Rodrig087/SistemaRegistroContinuo/Firmware/Datos pruebas/Datos pruebas.txt

Tramas de tiempo: 

 tramaTiempoSistema[0] = dia;
 tramaTiempoSistema[1] = mes;
 tramaTiempoSistema[2] = anio;
 tramaTiempoSistema[3] = hora;
 tramaTiempoSistema[4] = minuto;
 tramaTiempoSistema[5] = segundo;

tiempo[0] = 1;
tiempo[1] = 2;
tiempo[2] = 3;
tiempo[3] = 4;
tiempo[4] = 5;
tiempo[5] = 6;

horaSistema = 36672; //10:11:12
fechaSistema = 201216; //20/12/16

TEST = ~TEST;

Paths:
RC: C:\Users\milto\Milton\RSA\Git\Registro Continuo\SistemaRegistroContinuo\Firmware\Acelerografo
SE: C:\Users\milto\Milton\RSA\Git\Salud Estructural\SaludEstructuralCS\Firmware\Master
