Rodrig087/SistemaRegistroContinuo/Documentacion/Esquema/Captura.JPG

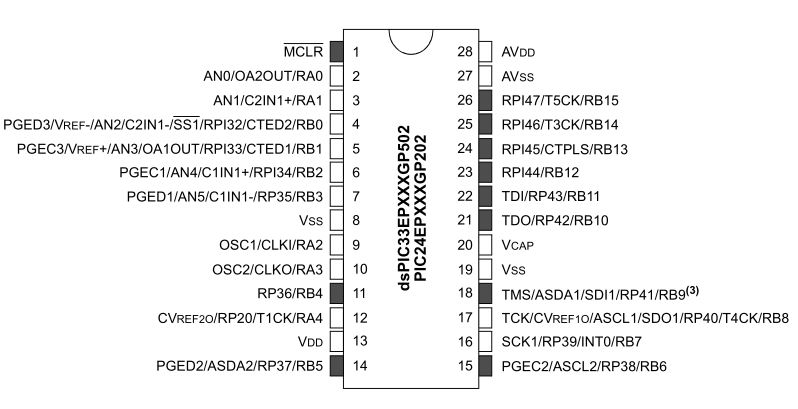
Documentacion/Esquema/Captura.JPG
