Rodrig087/SistemaRegistroContinuo/Documentacion/Esquema/BOM Acelerografo.xlsx

Item | Cantidad | Unidades en Chanlud | Unidades en Labrado | Unidades en Ocaña | Total
Raspberry Pi 3 B+ | 1 | 2 | 1 | 1 | 4
MicroSD 16GB Clase10 | 1 | 2 | 1 | 1 | 4
dsPIC 33EP256MC202 (o 502) | 1 | 2 | 1 | 1 | 4
ADXL355 | 1 | 2 | 1 | 1 | 4
DS3234 | 1 | 0 | 1 | 1 | 2
Modulo GPS Breakout 66 channel w/10 Hz | 1 | 0 | 1 | 1 | 2
Antena GPS | 1 | 0 | 1 | 1 | 2
Fuente 12V2A | 1 | 2 | 1 | 1 | 4
Convertidor DC-DC 5v | 1 | 0 | 1 | 1 | 2
ams1117 3.3v (o similar) | 1 | 0 | 1 | 1 | 2
Peineta hembra | 2 | 0 | 1 | 1 | 4
Peineta macho | 1 | 0 | 1 | 1 | 2
Zocalo 28 pines | 1 | 0 | 1 | 1 | 2
Jumper | 3 | 0 | 1 | 1 | 6
Pila de litio 3V CR1220 | 2 | 2 | 1 | 1 | 8
Holder CR1220 | 1 | 2 | 1 | 1 | 4
Molex 2 pines | 2 | 0 | 1 | 1 | 4
Pulsante | 1 | 0 | 1 | 1 | 2
Capacitor ceramico 1uF | 1 | 0 | 1 | 1 | 2
Capacitor ceramico 100nF | 9 | 0 | 1 | 1 | 18
Capacitor ceramico 10nF | 2 | 0 | 1 | 1 | 4
Capacitor electrolitico 220uF 25V | 1 | 0 | 1 | 1 | 2
Capacitor electrolitico 470uF 25V | 1 | 0 | 1 | 1 | 2
Diodo 1n914 | 1 | 0 | 1 | 1 | 2
Diodo 1n407 | 1 | 0 | 1 | 1 | 2
Resistencia 1K | 3 | 0 | 1 | 1 | 6
Resistencia 4,7K | 1 | 0 | 1 | 1 | 2
Resistencia 3,3K | 1 | 0 | 1 | 1 | 2
Resistencia 10K | 2 | 0 | 1 | 1 | 4
Resistencia 100K | 1 | 0 | 1 | 1 | 2
Led 3mm verde | 2 | 0 | 1 | 1 | 4
Conector RJ45 macho | 1 | 2 | 1 | 1 | 4
Conector AC | 1 | 2 | 1 | 1 | 4
Cable de poder | 1 | 2 | 1 | 1 | 4
Carcasa impresa en 3D | 1 | 2 | 0 | 0 | 2
Carcasa metalica | 1 | 0 | 1 | 1 | 2
Acrilico para montaje | 1 | 0 | 1 | 1 | 2
Bateria 12V | 1 | 3 | 2 | 1 | 6
