Rodrig087/SistemaRegistroContinuo/Software/W10/Convertidor de formato/configuracion_mseed.csv

ESTACION(21) | NOMBRE(0) | CODIGO(1) | SENSOR(2) | CANALES(3) | HAB_CANAL(4) | COMPONENTE(5) | HAB_GRAFICO(6) | HAB_PLT(7) | GAN_PLT(8) | GANANCIA(9) | DIEZ_PLT(10) | FACTOR_MUL(11) | CALIDAD(16) | UBICACION(17) | CANAL(18) | RED(19) | MUESTREO(20) | LONGITUD(12) | LATITUD(13) | ALTITUD(14) | RUIDO(15) | FILTRO(22) | RES1(23) | RES2(24)
1 | TESTX | TSTX | ACELEROGRAFICO | 3 | 1 | 3 | 1 | 1 | 200 | 1 | 5 | 19 | D | 0 | TRV | UC | 250 | -790.283 | -26.753 | 3423 | 0
