Rodrig087/SistemaRegistroContinuo/Software/W10/Convertidor de formato/Instrucciones.docx

Pasos para usar:

1. Los archivos binarios van en la carpeta EventosBin.

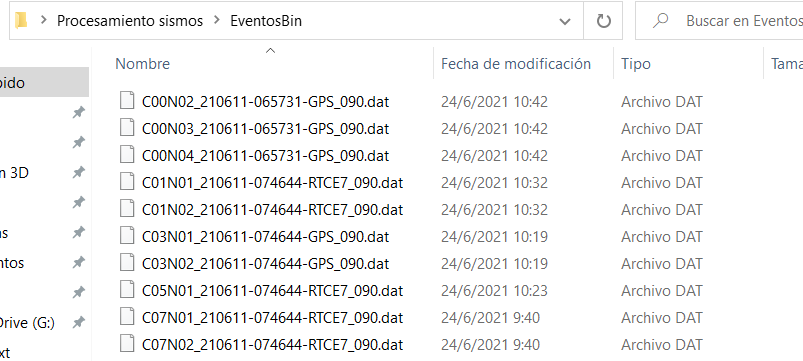
[picture p2: figure]

2. Se ejecuta el programa GraficarExtraerEvento.py.
3. Se coloca el nombre del archivo a convertir sin la extensión .bin.

Ejemplo: C00N02_210611-065731-GPS_090

Al dar enter el programa empieza el calculo y muestra la gráfica.

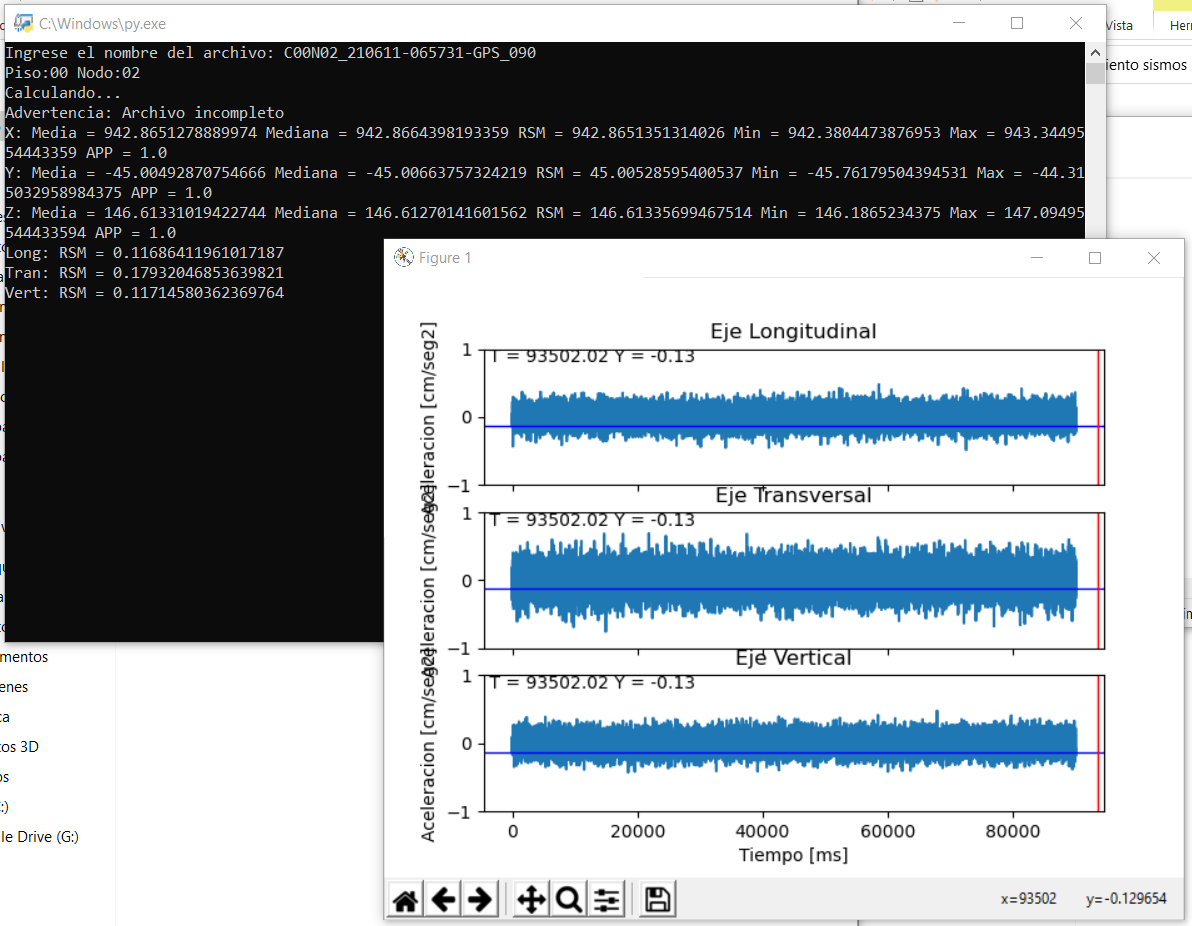
[picture p3: figure]

4. Al cerrar el grafico el programa pregunta si se desea extraer el evento.

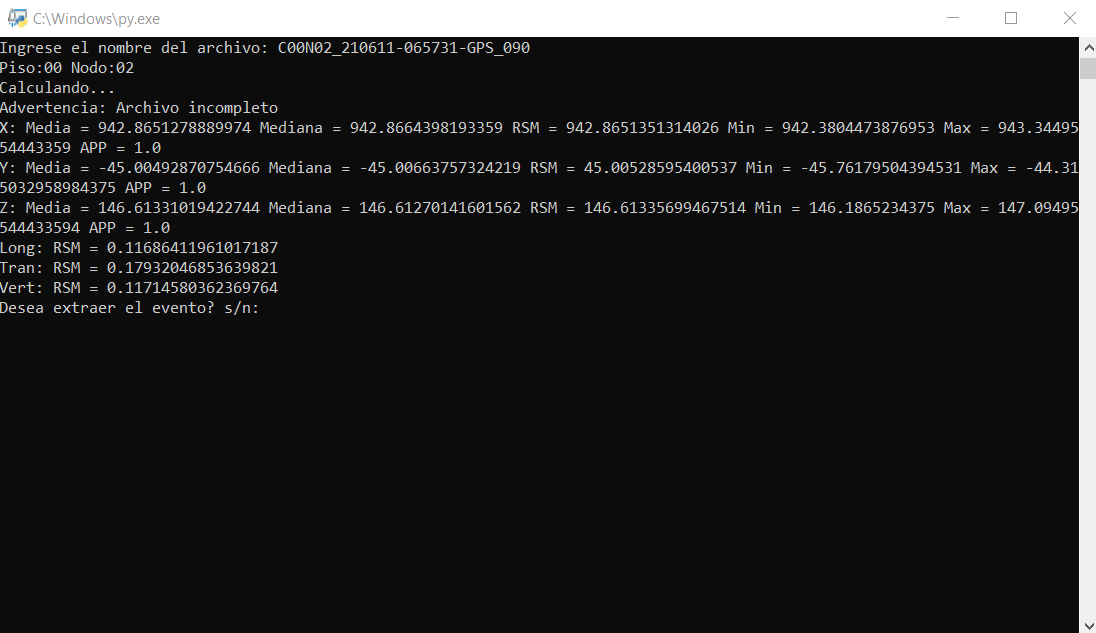
[picture p4: figure]

5. Si se selecciona la opción “s”, el programa extraerá el evento en formato texto en la carpeta EventosTxt y se cerrará de forma automática.

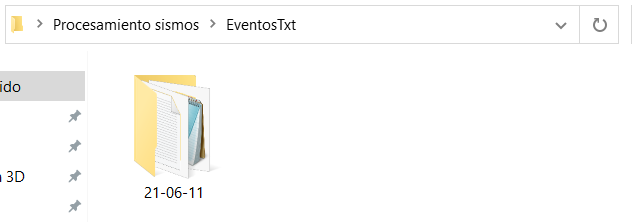
[picture p5: figure]
