Rodrig087/SistemaRegistroContinuo/Documentacion/Esquema/Esquema 3.pdf

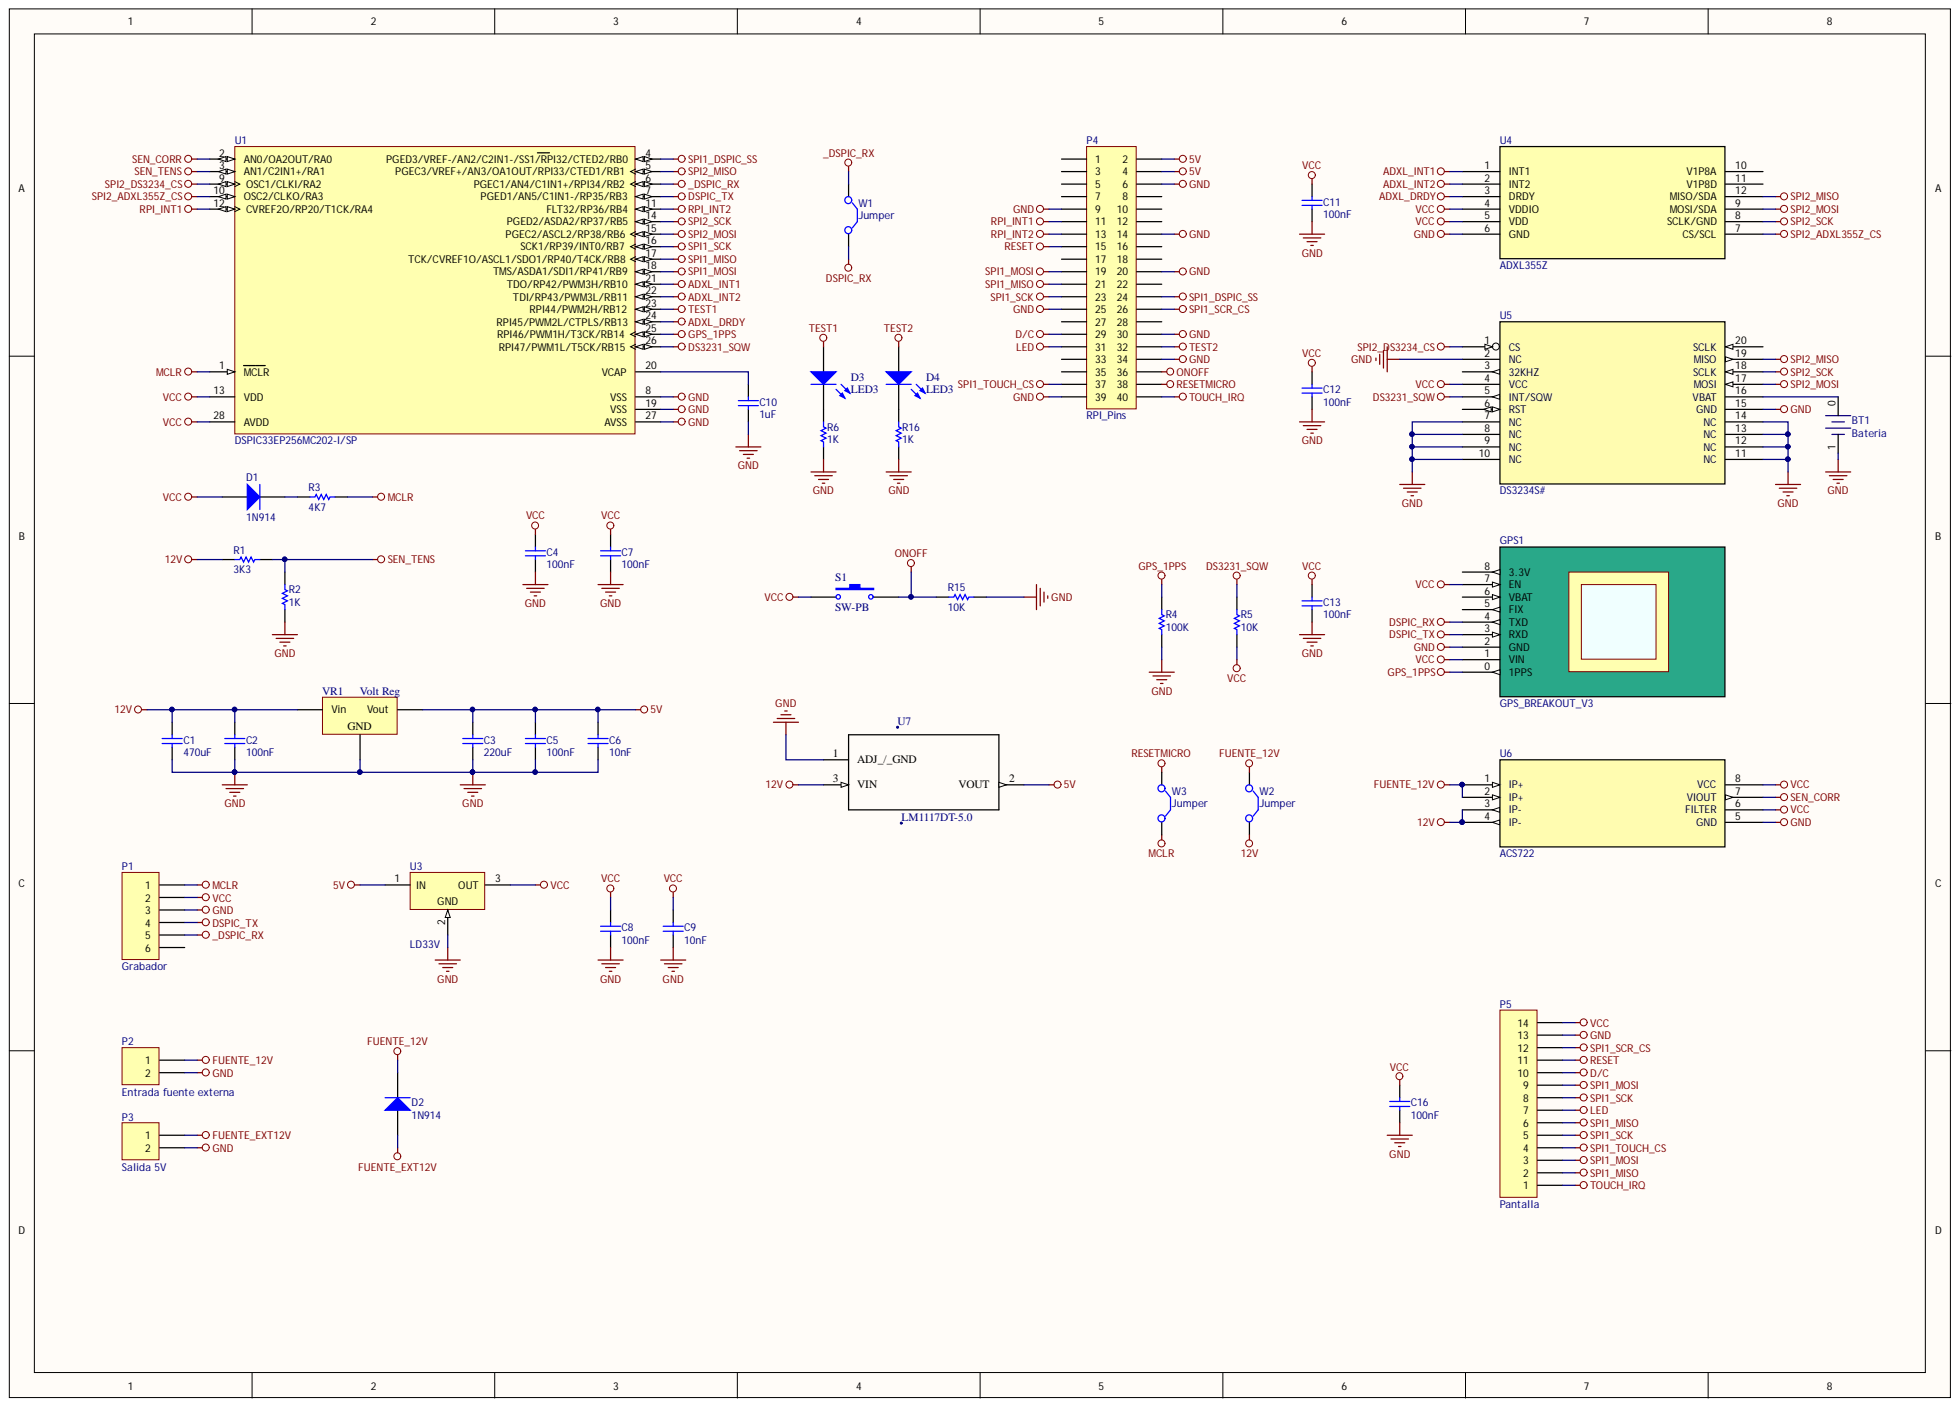
[picture p6: page 1]
