Rodrig087/SistemaRegistroContinuo/Documentacion/Esquema/Esquema2.pdf

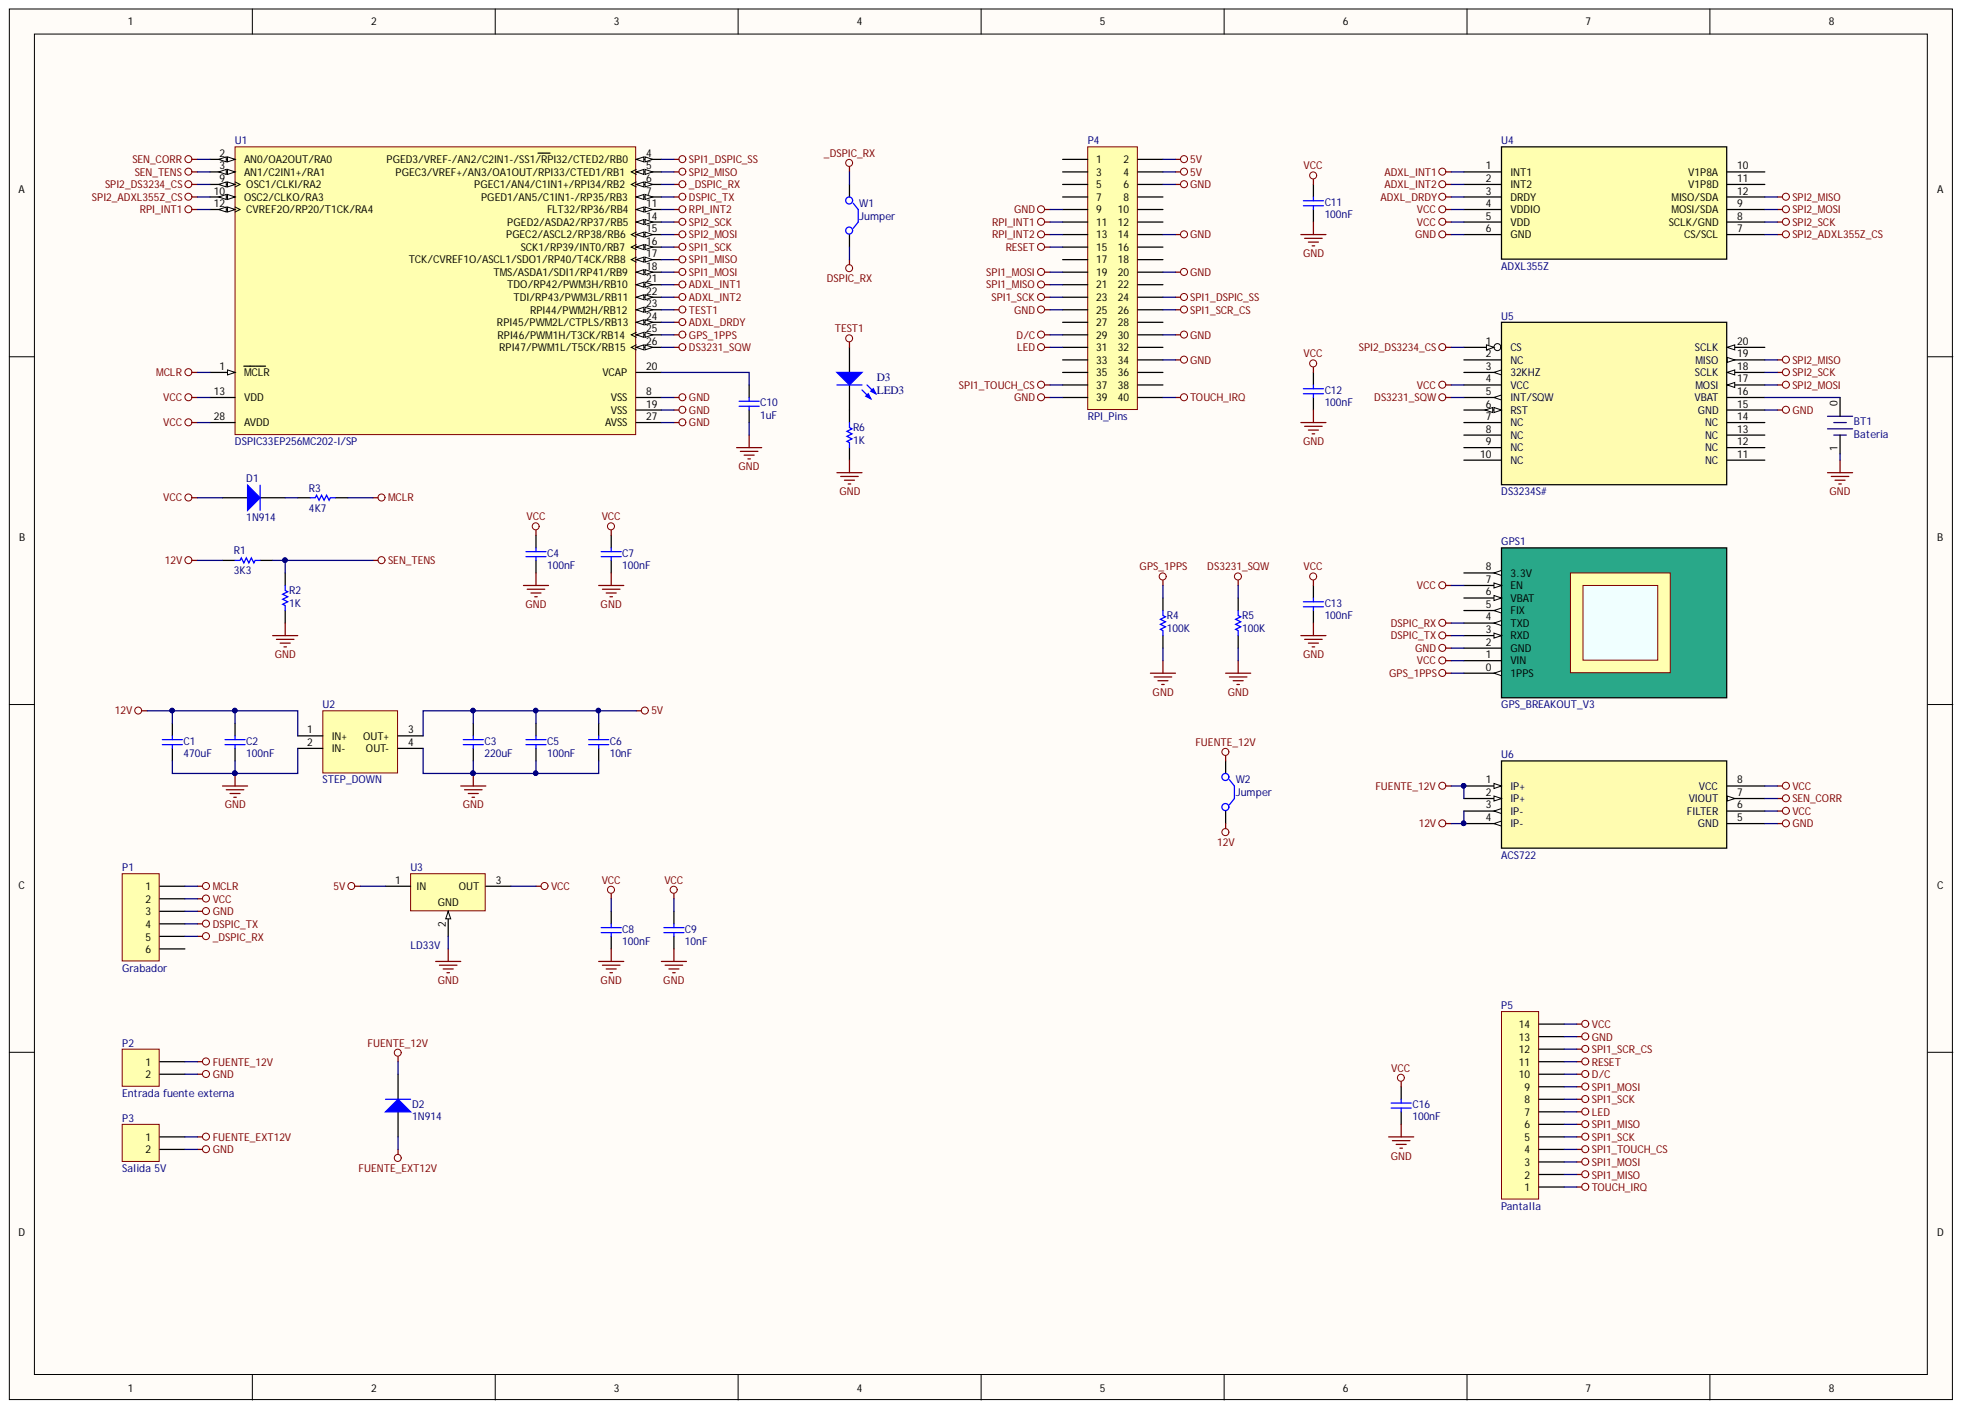
[picture p7: page 1]
