Rodrig087/SistemaRegistroContinuo/Documentacion/Esquema/EsquemaAntiguo.pdf

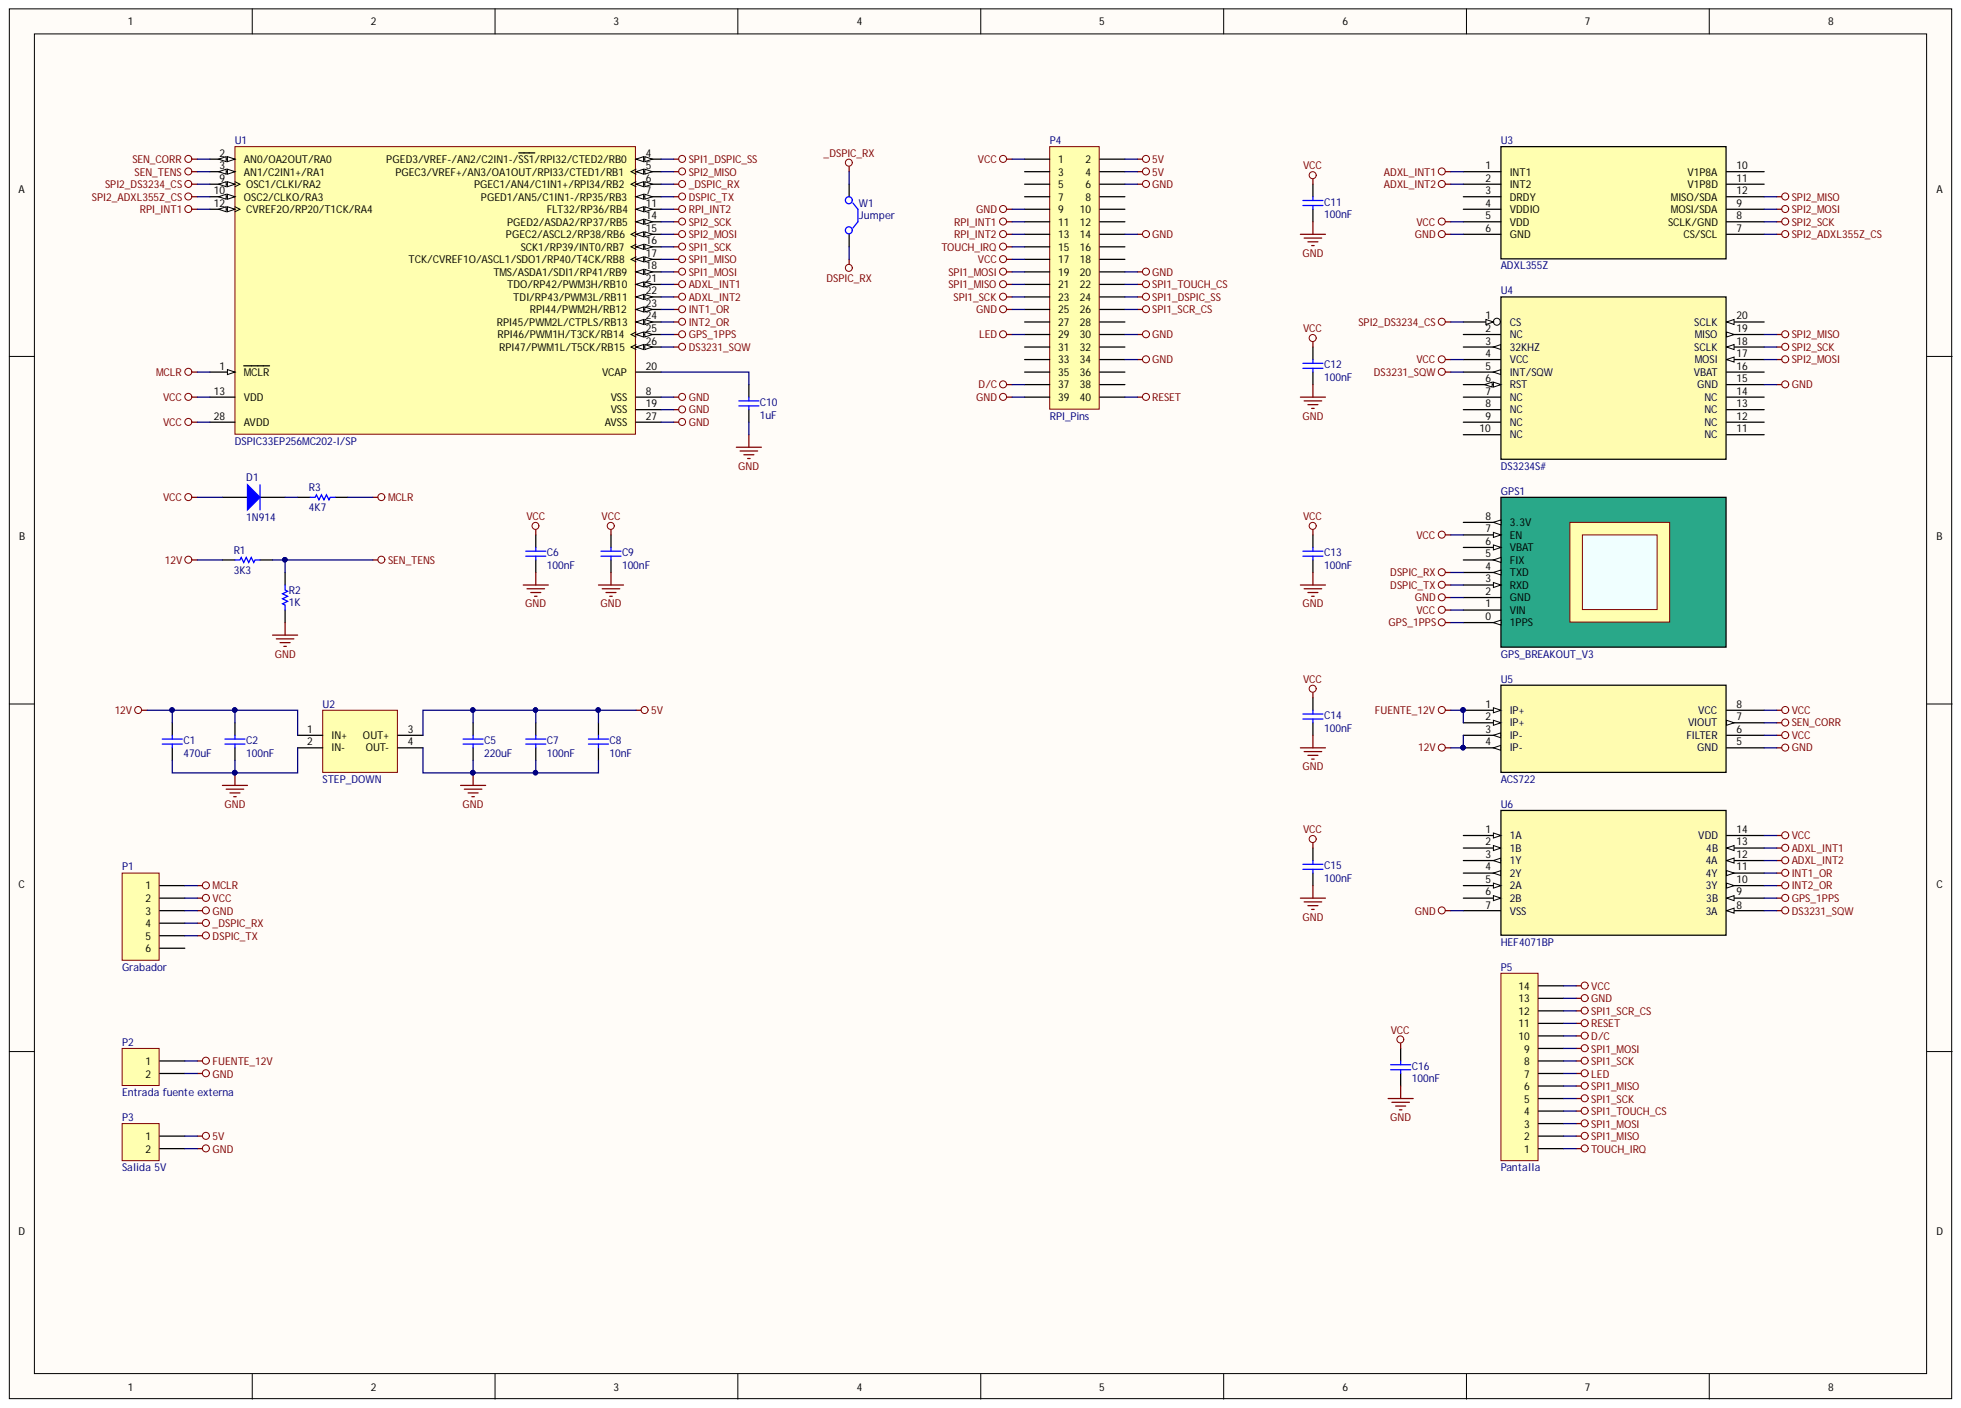
[picture p8: page 1]
