Rodrig087/SistemaRegistroContinuo/(list of files, drawings)

Other design files:
Firmware/Concentrador Principal/Simulacion/SimulacionCP.pdsprj
Firmware/Esclavo/Simulacion/Simulacion.pdsprj
Firmware/Simulacion/Simulacion.pdsprj
Firmware/SimulacionPrincipal/Completa/Simulacion.pdsprj
Firmware/Vertedero/DSP/Simulacion/ADC_DAC.pdsprj
Pruebas/SPI_ConcentradorPrincipal/Simulacion/SimulacionCP.pdsprj
Pruebas/SPI_MaestroEsclavo/Pruebas.pdsprj
RedDatos/Simulacion/Splitter.pdsprj
RedDatos/Splitter/Simulacion/Splitter.pdsprj
