Rodrig087/SistemaRegistroContinuo/Software/RPi/Python/ResetOffButton.py

#!/usr/bin/python
# shutdown/reboot(/power on) Raspberry Pi with pushbutton

import RPi.GPIO as GPIO
from subprocess import call
from datetime import datetime
import time

# pushbutton connected to this GPIO pin, using pin 36 gpio16 also has the benefit of
# waking / powering up Raspberry Pi when button is pressed
shutdownPin = 36

# if button pressed for at least this long then shut down. if less then reboot.
shutdownMinSeconds = 3
led = 40

# button debounce time in seconds
debounceSeconds = 1

GPIO.setmode(GPIO.BOARD)
GPIO.setup(shutdownPin, GPIO.IN, pull_up_down=GPIO.PUD_UP)
GPIO.setup(led, GPIO.OUT)

buttonPressedTime = None

# Enciende el led
GPIO.output(led, GPIO.HIGH)


def buttonStateChanged(pin):
    global buttonPressedTime

    if not (GPIO.input(pin)):
        # button is down
        if buttonPressedTime is None:
            buttonPressedTime = datetime.now()
    else:
        # button is up
        if buttonPressedTime is not None:
            elapsed = (datetime.now() - buttonPressedTime).total_seconds()
            buttonPressedTime = None
            if elapsed >= shutdownMinSeconds:
                # button pressed for more than specified time, shutdown
                call(['shutdown', '-h', 'now'], shell=False)
            elif elapsed >= debounceSeconds:
                # button pressed for a shorter time, reboot
                #call(['shutdown', '-r', 'now'], shell=False)
                call(['reboot'], shell=False)


# subscribe to button presses
GPIO.add_event_detect(shutdownPin, GPIO.BOTH, callback=buttonStateChanged)

while True:
    # sleep to reduce unnecessary CPU usage
    time.sleep(5)
