Rodrig087/SistemaRegistroContinuo/(commit log)

2018-08-01 Se agredo el software de los dispositivos hub-splitter desarrollados en el trabajo de titulacion
    [Splitter.cfg]
2018-08-01 Se agrego un archivo de simulacion en Proteus
    [Splitter.cfg, Splitter.pdsprj]
2018-08-02 Se agregaron los programas de los dispositivos Master y Esclavo del proyecto de titulacion. Ademas se agrego un archivo de simulacion que contiene los 3 dispositivos
    [Esclavo.cfg, Master.cfg, Splitter.pdsprj]
2018-08-03 Se implemento un algoritmo de calculo de CRC16 y se comprobo su correcto funcionamiento en arrays de 4 y 6 elementos
    [Splitter.pdsprj]
2018-08-06 Se establecio la estructura de la trama de datos de peticion y respuesta en un modelo inspirado en el protocolo Modbus ASCII. Esta trama esta conformada por 4 elementos: Header, PDU, CRC y End. El He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
    [Splitter.pdsprj]
2018-08-07 Se modifico el programa del Master para enviar una trama de peticion cada vez que se pulsa un boton. No esta calculando bien el CRC enviado en la trama de peticion. Tambien se implemento un algoritmo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
    [Splitter.pdsprj]
2018-08-13 Se implemento el programa en el dispositivo esclavo, el cual cumple los siguientes pasos: 1. Recibe la trama de peticion y la almacena si cumple las condiciones de delimitacion de trama. 2. Verifica 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
    [Splitter.pdsprj]
2018-08-13 Se implemento un ejemplo completo, donde el maestro realiza una peticion al esclavo cada vez que se presiona un pulsante, y cuando recibe una respuesta satisfactoria enciende un led. Se modificaron l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
    [Splitter.pdsprj]
2018-08-15 Se implemento el TimeOut mediante una interrupcion del TMR1 que inicia su conteo cada vez que inicia una trama. Se comprobo su funcionamiento estableciendo tiempos de interrupcion menores y mayores c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
    [Splitter.pdsprj]
2018-08-16 Se modifico el programa para incluir una funcion que se encarga de armar y enviar las tramas sobre bus RS485. En el maestro esta funcion necesita el numero de bytes de pyload y la funcion requerida, 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
    [Splitter.pdsprj]
2018-10-17 Se cambio el nombre de la carpeta que contiene el proyecto a Firmaware. Ademas de borro las carpetas de los programas que contenian los programas del Esclavo, el Master y sus simulaciones.
    [Master.cfg, Splitter.cfg, Splitter.pdsprj]
2018-10-31 Se esta trabajando en el protocolo de comunicacion de los dispositivos MasterComunicacion y HubSplitter
    [MasterComunicacion.cfg, Simulacion.pdsprj, Splitter.cfg]
2018-11-05 Se esta implementando una simulacion para comprobar el intercambio de tramas de datos entre el Maestro y el Esclavo sin el Splitter
    [EsclavoComunicacion.cfg, Simulacion.pdsprj]
2018-11-08 Se corrigio el problema de la funcion VerficarCRC en el Esclavo cambiando la longitud del vector PDU, al parecer da errores cuando se le fija una longitud mayor a 30 elementos. Tambien se comprobo qu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
    [EsclavoComunicacion.cfg, MasterComunicacion.cfg, Simulacion.pdsprj]
2018-11-28 Se agrego una carpeta de pruebas donde esta un ejemplo de comunicacion SPI entre un Maestro y un Esclavo por medio de interrupciones externas y por SPI totalmente funcional.
    [EComunicacionPrueba.cfg, ESensorPrueba.cfg, EsclavoSensor.cfg, HSPrueba.cfg, Pruebas.pdsprj, RpiSimulacion.cfg, Simulacion.pdsprj]
2018-11-30 Los modulos EsclavoComunicacion y EsclavoSensor funcionan correctamente
    [Simulacion.pdsprj]
2018-12-06 Se hicieron algunos cambios menores. Ahora el campo #Datos indica el numero de bytes del pyload el lugar de la trama PDU. Tambien se implemento una funcion que devuelve un mensaje de error pasandole 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
    [Simulacion.pdsprj]
2018-12-07 Se realizo la validacion en el modulo EsclavoComunicacion de las funciones y registros disponibles del modulo EsclavoSensor. Hasta ahora esta funcionando bien las validaciones correspondientes a las 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
    [Simulacion.pdsprj]
2018-12-07 Se agrego al modulo EsclavoComunicacion la funcion que permite enviar solicitudes de escritura por SPI al modulo EsclavoSensor. Esta funcion recibe como parametro el registro que se quiere escribir, 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
    [Simulacion.pdsprj]
2018-12-11 Se termino de implementar el metodo en el modulo EsclavoSensor que permite recibir por SPI la trama de datos que se escibira en el registro de escritura deseado
    [Simulacion.pdsprj]
2019-01-16 Se esta trabajando en el Concentrador principal. Hasta ahora se eleboro un script que permite recibir la peticion procedente de la RPi a travez del puerto SPI y reenviarla por medio del puerto UART (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
    [CPComunicacion.cfg, EsclavoComunicacion.cfg, EsclavoComunicacionMultiple.cfg, EsclavoSensor.cfg, RPi_Simulacion.cfg, RpiSimulacion.cfg, Simulacion.pdsprj, SimulacionCP.pdsprj]
2019-01-22 Se termino de implementar el programa del Concentrador Principal (CPComunicacion). Por ahora se envia una peticion por SPI desde la RPi simulada, el CPComunicacion la recibe y la reenvia por medio de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
    [MasterComunicacion.cfg, SimulacionCP.pdsprj]
2019-01-24 Se depuro el programa del CPComunicacion y se agregaron los metodos que permiten enviar mensajes de error a la RPi por medio de SPI cuando ocurren fallas en el canal RS485 y cuando el dispositivo H/S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
    [SimulacionCP.pdsprj]
2019-02-15 Se realizo el respaldo de los programas de la RPi incluidos los programas en C para el acelerografo del Ing Remigio
    [CPComunicacion.cfg, EsclavoAcelerometro.cfg, RPi_Simulacion.cfg, Simulacion.pdsprj, SimulacionCP.pdsprj]
2019-02-25 Se logro establecer una comunicacion correcta entre el pic y la RPi para el intercambio de los 9 bytes de datos de ejemplo cada 5ms.
    [SimulacionCP.pdsprj]
2019-03-01 Se agrego los programas en C para la RPi que permiten la toma de muestras por SPI y su almacenamiento en un archivo binario. Tambien se incluyo un programa en C que interpreta dicho archivo binario y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
2019-03-14 Se implemento un software(V5) que permite guardar los datos recibidos a traves del puerto SPI de la RPi y guardarlo en un archivo binario, sin presentar perdida de datos (por segundo) en mas de 12 ho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
2019-03-22 Se realizo la migracion del programa del PIC18 al dsPIC. Por ahora hace exactamente lo mismo y ahora se esta implementando la comuncacion con el acelerometro.
    [Acelerografo.cfg, EsclavoAcelerometro.cfg, RPi_Simulacion.cfg]
2019-03-29 Ya se logro obtener datos del acelerometro utilizando la direccion FIFO
    [Acelerografo.cfg]
2019-04-02 Checkpoint: Hasta aqui funciona relativamente bien, se cambio la funcion ADXL355_muestra para que almacene los valores de FIFO como posiciones de un vector en lugar de posiciones de punteros. Se real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
    [Acelerografo.asm, Acelerografo.c]
2019-04-08 Se agrego una segunda version del programa que realiza la conversion del archivo .dat a .txt. Ahora el programa recibe como parametros el numero de lineas que se desea convertir y el nombre del archi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
2019-04-08 Se agrego una sexta version del programa de muestreo que perimte generar el archivo binario de salida con el nombre de la fecha y la hora en la que fue generado (AAAAMMDDHHmm.dat)
2019-04-09 Se modifico el programa PAE_V6 para que genere un nuevo archivo binario a una determinada hora del dia
2019-04-10 Se corrigio el problema en el programa ConvertirBinario_V2 que hacia necesario pedir mas de 200 muestras para que empiece a guardar datos en el archivo de texto de salida.
2019-04-17 Se implemento un programa de prueba en el dsPIC para obtener la informacion del FIFO. Se cambio la frecuencia de muestreo a 250 muestras por segundo (4ms) y se fijo en 50us el tiempo entre byte en el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
    [Acelerografo.asm, Acelerografo.c]
2019-04-18 Editando: Se estan editando los progrmas del dsPIC y la RPi para una tasa de muestreo de 250Hz. Por ahora no funciona bien, presenta algunos errores al reconstruir la señal.
    [Acelerografo.asm, Acelerografo.c]
2019-04-23 Esta es una version funcional de Firmware y Software. Incluye los archivos del dsPIC con una frecuencia de muestreo de 200 muestras por segundo y los archivos para convertir el archivo binario en for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
2019-05-10 Se implemento los programas que permiten recuperar el contenido del buffer FIFO cada 100 ms, entramarlos en una trama larga con el contenido de un segundo y enviarlo a la RPi. Por ahora funciono corr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
    [Acelerografo.asm, Acelerografo.c]
2019-05-31 Editando. Se esta implementando la recuperacion de la fecha y hora desde el GPS. Por ahora funciona bien la parte que configura el GPS al inicio, y el programa ya es capaz de recuperar la hora correc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
    [Acelerografo.asm, Acelerografo.c]
2019-07-03 Editando: Hasta ahora se implemento dos funciones que toman la trama de datos GPS y extraen la hora y la fecha en formato long, luego estos dos numeros se ingresan en otra funcion que ademas recibe c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
    [Acelerografo.asm, Acelerografo.c, LeerGPS.c]
2019-07-09 Version funcional del firmware y software que permite un muestreo y almacenamiento a 250 muestras por segundo
2019-07-11 Funcionando: Se modifico el firmware del acelerografo para seleccionar la tasa de muestreo requerida. Las posibles frecuencias son de 250, 125, 62.5 y 31.25 Hz, y almacenanan datos cada 1, 2, 4 y 8 s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
2019-07-19 Se modifico el software ConvertidorBinario_V4 debido a que estaba calculando erroneamente el complemento A2 y esto producia que interpretara mal los datos negativos del acelerometro. Ahora el program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
    [ComplementoA2.c]
2019-08-13 Se soluciono el problema del UART. El problema fue en el FIFO. Se coriigio el firmware y software para enviar la trama tiempo de ejemplo del dsPIC a la RPi.
    [Acelerografo.asm, Acelerografo.c, ComplementoA2.c, LeerArchivo.c, LeerGPS.c, PruebaInterrupcion.c]
2019-08-29 Hasta aqui se tiene una version sin errores. Esta pendiente el guardar el ultimo segundo de muestreo en el archivo antes de crear un archivo nuevo.
    [Acelerografo.asm, Acelerografo.c]
2019-09-03 Se corrigio el problema que hacia que se corrompa la primera trama que llega despues de abrir un nuevo archivo. Falta solucionar el problema de ajuste de fecha despues de las 00:00 en el dsPIC.
    [Acelerografo.asm, Acelerografo.c]
2019-09-05 Se agrego 2 campos a la trama tiempo para indicar si se actualizo la hora del sistema con el GPS y para indicar si se incremento el tiempo con un pulso del GPS o del RTC.
2019-09-06 La version anterior presenta algunos problemas, tal vez en el firmware, por esta razon se volvio a la version anterior. Posteriormente se tratara de solucionar este problema cuando se tenga la placa 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
    [Acelerografo.asm, Acelerografo.c, ConvertirBinario_V6.c]
2019-09-13 Se implemento el programa PAE_V12 para actualizar el reloj interno de la RPi con la hora recibida del GPS. Tambien guarda los datos en la Pendrive en lugar de la memoria interna.
2019-09-20 Instalado y funcionando. Se implementaron algunos scripts para administar la usb donde se almcenan los datos (montar,desmontar y borrar). Tambien se implemento un programa que registra el consumo de 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
2019-10-22 Se implementaron shell-scripts de ayuda e informacion. Tambien se modifico el firmware para que se obtenga la hora del GPS hasta en 3 intentos
    [ADC_DAC.cfg, ADC_DAC.pdsprj, Consumo.xlsx, DSP.cfg, Esclavo.cfg, Master.cfg, Splitter.cfg, UART_LCD.cfg]
2019-11-07 Se borraron todos los archivos que no tienen relacion con este proyecto
    [ADC_DAC.cfg, ADC_DAC.pdsprj, Acelerografo.cfg, CPComunicacion.cfg, Consumo.xlsx, DSP.cfg, EComunicacionPrueba.cfg, ESensorPrueba.cfg]
2019-11-07 Se volvio a la version anterior del firmware del acelerografo quitando los 3 intentos de sincronizacion del reloj
2019-11-11 Se cambio la forma de lectura del buffer FIFO a una lectura fija de 25 muestras
2019-11-12 Se modifico el firmware para incluir informacion sobre el bit FIFO_OVR en la trama de datos (bit 3 del byte LSB del eje X de la primera muestra)
2019-11-14 Se modifico el Firmware para detener el acelerometro al iniciar el dsPIC y al recibir las instrucciones de detener e iniciar el muestreo. De esta manera se soluciono el problema del desborde del FIFO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
    [Acelerografo.asm, Acelerografo.c]
2019-12-12 Se descarto el ultimo cambio en el Firmware. Se desarrollaron dos programa en C para W10 para realizar la conversion de binario a texto en dos formatos distintos.
2020-01-02 Se regreso a la version del firmware del 11 de noviembre
2020-01-02 Se modifico el Software y el Firmware para que el dsPIC obtenga la hora y fecha de la RPi pero que trabaje con el pulso PPS del GPS.
2020-01-14 Se corrigieron los errores del Firmware que producian problemas en el manejo del tiempo del sistema. Tambien se modifico el Software para reiniciar el microcontrolador cada vez que se ejecuta el prog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
    [Acelerografo.asm, Acelerografo.c]
2020-01-17 Se implemento una hoja de calculo para localizar los eventos detectados en los archivos resultantes del sistema continuo
    [Eventos.xlsx]
2020-01-27 Se eliminaron las carpetas RPi_Acelerometro y EsclavoAcelerometro de la carpeta Firmware y se agrego la carpeta Libreias que contiene las libreias de control del GPS y RTC DS3234 ademas del archivo d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
    [EsclavoAcelerometro.cfg, Eventos.xlsx, RPi_Simulacion.cfg]
2020-02-10 Se modifico el software de registro continuo y se implemento uno nuevo para comprobar el funcionamiento del sistema mediante la observacion instantanea de los datos de tiempo y acelaracion de la tram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
2020-02-11 Se modifico el software de comprobacion debido a que la version anterior hacia que la RPi se cuelgue despues de cierto tiempo. La nueva version guarda el nombre del nuevo archivo binario dentro de un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
2020-02-14 Se implemento un software en C para controlar el funcionamiento del sofware de registro continuo. Tambien se implemento un sofware en C para W10 para extraer el evento sismico en base al nombre del a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
2020-02-14 Se implemento la segunda version del software para extraer eventos, el cual devuelve una cabecera con los datos de periodo de muestreo, hora y fecha de inicio, y duracion de la ventana extraida. Tamb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
2020-02-17 Se organizaron por categoria los programas para W10.
    [Eventos.xlsx]
2020-02-17 Se empezo a desarrollar una segunda version del sistema de registro continuo en la cual se toma el tiempo del GPS para igualar el RTC y los pulsos de inicio de muestreo son suministrados por el RTC e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
2020-02-26 Esta es una version funcional del sistema que se instalo en el edificio de la CS el dia 2020/02/21. La referencia de tiempo es tomada del RTC el cual fue igualado con la hora de la RPi utilizando el 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
2020-03-03 Se esta trabajando sobre el GPS del dsPIC para poder configurarlo y comprobar su funcionamiento desde la RPi
    [Configuracion red.txt]
2020-03-06 Se modifico el programa SetRTC de la RPi para corregir problemas en los metodos que iguala el reloj RTC del PIC y el que recibe el tiempo de este. Hasta aqui funcionan de forma confiable y se depuro 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
    [Acelerografo.asm, Acelerografo.c]
2020-03-10 Se corrigieron los errores en el software y firmware para obtnere la hora del RTC y el GPS. Tambien se incluyo un byte en la trama tiempo para identificar si la hora se obtuvo del GPS o del RTC
    [Acelerografo.asm, Acelerografo.c]
2020-03-10 Se implemento una nueva version del software RegistroContinuo (version 6) para ser compatible con el ultimo firware del dsPIC. Funciona bien.
2020-03-13 Se esta trabajando en el software de Python que convierte la trama binaria a formato miniseed
2020-04-09 Se implemento un programa en Python para apagar y resetear la Rpi pulsando un boton. No funciona muy bien, solo sirve la funcion de apagado.
    [BinarioToMiniSeed.py, BinarioToMiniSeed_V12.py, ComprobarTrama.py, ComprobarTramaTemp.c, ControladorRegistro_V1.c, RegistroContinuo_V1.7.c, ResetOffButton.py]
2020-08-25 Se desarrollou n programa en Python para visualizar los eventos de todo el dia. Se incluyeron las instrucciones para generar un ejecutable con pyinstaller.
    [Configuracion red.txt]
2021-03-26 Se agregaron programas para extraer los eventos sismicos a partir del registro continuo en formato binario y de texto.
    [BOM Acelerografo.xlsx]
2021-04-06 Se corrigio el problema de ajuste de hora del RTC despues de las 20 horas. Se implemento un sotware en C para la Raspberry Pi para extraer los eventos en formato de archivo binario ingresando como pa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
    [Acelerografo.asm, TIEMPO_RTC.c]
2021-12-18 Se hicieron muchos cambios desde el ultimo commit. El ultimo fue que se agrego un programa para W10 que permite subir archivo a Google Drive mediante una API para Python.
    [Configuracion red.txt, Eventos.xlsx]
2021-12-20 En proceso
    [DatosConfiguracion.txt]
2021-12-21 Se modificaron los programas RegistroContinuo_V35.c y ComprobarRegistro_V3.c para que guarde y lea los nombres de los archivos actual y anterior de registro continuo. Ojo: El archivo /TMP/NombreArchi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
2021-12-21 Se corrigio el problema de escritura del archivo /TMP/NombreArchivoRegistroContinuo.tmp
    [RegistroContinuo_V35.c]
2021-12-22 Se implemento el programa para subir los archivos a Drive desde la RPi utilizando los archivos de configuracion y de los nombres de los archivos binarios de registro continuo. Funciona bien con archi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
    [DatosConfiguracion.txt]
2021-12-22 En proceso. No funciona para archivos grandes
2021-12-23 Se soluciono el problema con la API de Google Drive que no permitia subir archivos grandes. Funciona bien en W10 pero en la Raspberry aparecio otro error de desbordamiento de memoria.
    [SubirArchivoDrive.py, SubirRegistroDrive.py]
2021-12-23 Se soluciono el problema de desborde de memoria en la Rpi. Se hicieron algunas pruebas y se comprobo que funciona bien.
    [SubirArchivoDrive.py, SubirRegistroDrive.py]
2021-12-28 Se termino de corregir los programas RegistroContinuo_V35.c y SubirRegistroDrive.py para que suban los registros de los acelerografos automaticamente a Drive.
2021-12-31 Se implemento el programa SubirDirectorioDrive.py para subir los registros y los eventos extraidos a Google Drive.
2022-01-26 En proceso: Se agrego un programa para generar un pulso PPS en la RPi para realizar pruebas de sincronizacion. Todavia no funciona.
2022-02-04 Se implemento el programa GraficarExtraerEvento.py para graficar y convertir a formato texto los eventos en formato binario extraidos por los acelerografos del registro continuo y el sistema de SHM.
2022-05-09 Se implemento un programa que elimina los archivos del Registro Continuo a excepcion de los correspondientes a los 2 ultimos meses
2022-05-09 Se modifico el programa de limpieza del registro continuo para que los nombres de los archivos coincidan con el formato de los nombres de las estaciones instaladas.
2022-05-09 Se realizaron optimizaciones y correcciones al codigo de limpieza del registro continuo
2022-07-08 Se implemento un programa para monitorizar la escritura de un archivo temporal que guarda la trama de datos de un segundo. Algo esta fallando, indica doble escritura por cada ciclo.
2022-07-12 Se implemento un programa en Python que grafica en tiempo real el acelerograma a una tasa de una muestra por segundo.
2022-07-22 Pequeño cambio. Se cambio el nombre de la variable TEST por LedTest.
2022-08-17 Se agrego la version del software desarrollado en la version SyncGPS_V2 y se modifico el firmware para que la solicitud del tiempo RTC sea compatible con esta version. Compilado y funcionando.
2022-08-17 Se implemento la lectura del GPS y el inicio del muestreo. Compilado y funcionando.
2022-08-17 Se implemento el timeout para el GPS. Compilado y funcionando.
2022-08-18 Se implemento la sincronizacion de los pulsos PPS y SQW. La presicion varia entre 18 y 160us. Compilado y funcionando.
2022-08-25 Se realizaron algunos cambios en los programas ComprobarRegistro_V3.c para incluir mas informacion, y en el programa RegistroContinuo_V35.c para seleccionar la fuente de tiempo mas conveniente. Compi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
    [BOM Acelerografo.xlsx]
2022-08-30 Se implemento el retraso de 500ms necesario para la sincronizacion de los pulsos PPS y SQW mediante el TMR3. Se escribio en el archivo crontab.txt de la carpeta Scripts la configuracion utilizada en 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
    [Acelerografo.asm, Acelerografo.c]
2022-09-22 Se agregaron los programas IniciarGPS.c y ResetMaster.c a la carpeta /Software/RPi/C/Operacion/
    [IniciarGPS.c, ResetMaster.c]
2023-03-09 Se modifico el script registrocontinuo para incluir la subida automatica del registro a Google Drive. Se agrego un programa en Python que sube archivos del registro continuo a Drive pasando como para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
2023-03-15 Se re organizaron los archivos y directorios
    [Configuracion red.txt, DatosConfiguracion.txt]
2023-03-23 Se agregó el escript de configuracion de la red ad hoc del acelerografo CHA02
2023-03-28 Se soluciono el problema de inicializacion del GPS. Se realizaron comprobaciones en la terminal y en las graficas de los eventos extraidos y se comfirmo que todo funciona correctamente.
    [Acelerografo.asm, Acelerografo.c]
2023-04-25 Se empezo la implementacion de un bot de Telegram
2023-04-26 Bot de Telegram en proceso
2023-05-19 Se corrigio la fecha en la libreria del GPS
    [Acelerografo.asm]
2023-06-14 Se modifico el firmware para corregir el problema de sincronizacion con el GPS y la RPi. Se modificaron las librerias para ajustarse al estandar recomendado.
    [ADXL355_SPI.asm, ADXL355_SPI.h, Acelerografo.asm, Acelerografo.c, TIEMPO_GPS.asm, TIEMPO_RPI.asm]
2023-08-03 Se agrego un pograma y para convertir los archivos binarion a formato mseed y otro programa para Graficar y extraer los eventos.
    [configuracion_mseed.csv]
2023-08-28 Se modifico el firmware para hacer pruebas de sincronizacion cambiando el pulso de muestreo SQW por el PPS. Se modifico el programa ConversorMseed.py para reparar los archivos binarios incompletos.
    [configuracion_mseed.csv]
2023-09-13 Modificacion firmware: Se realizo una modificacion en la comunicacion SPI en la instruccion A4-F4 para sincronizar el RTC con la hora de red
2023-09-21 Correccion: Se corrigio la funcion lectura_archivo() del programa CoversorMseed.py para que pueda detectar varias muestras faltantes consecutivas
